IronMakersOficial/PCB_Line_Follower/README.md

# PCB_Line_Follower
https://docs.google.com/presentation/d/18NeSRMtTCqL56gMsUclv35SEyPV9ovb3Qi_COdJcdes/edit?usp=sharing
