IronMakersOficial/PCB_Line_Follower/Follower_Line_Circuito_Esquematico_Placa_Iron_Makers.jpg

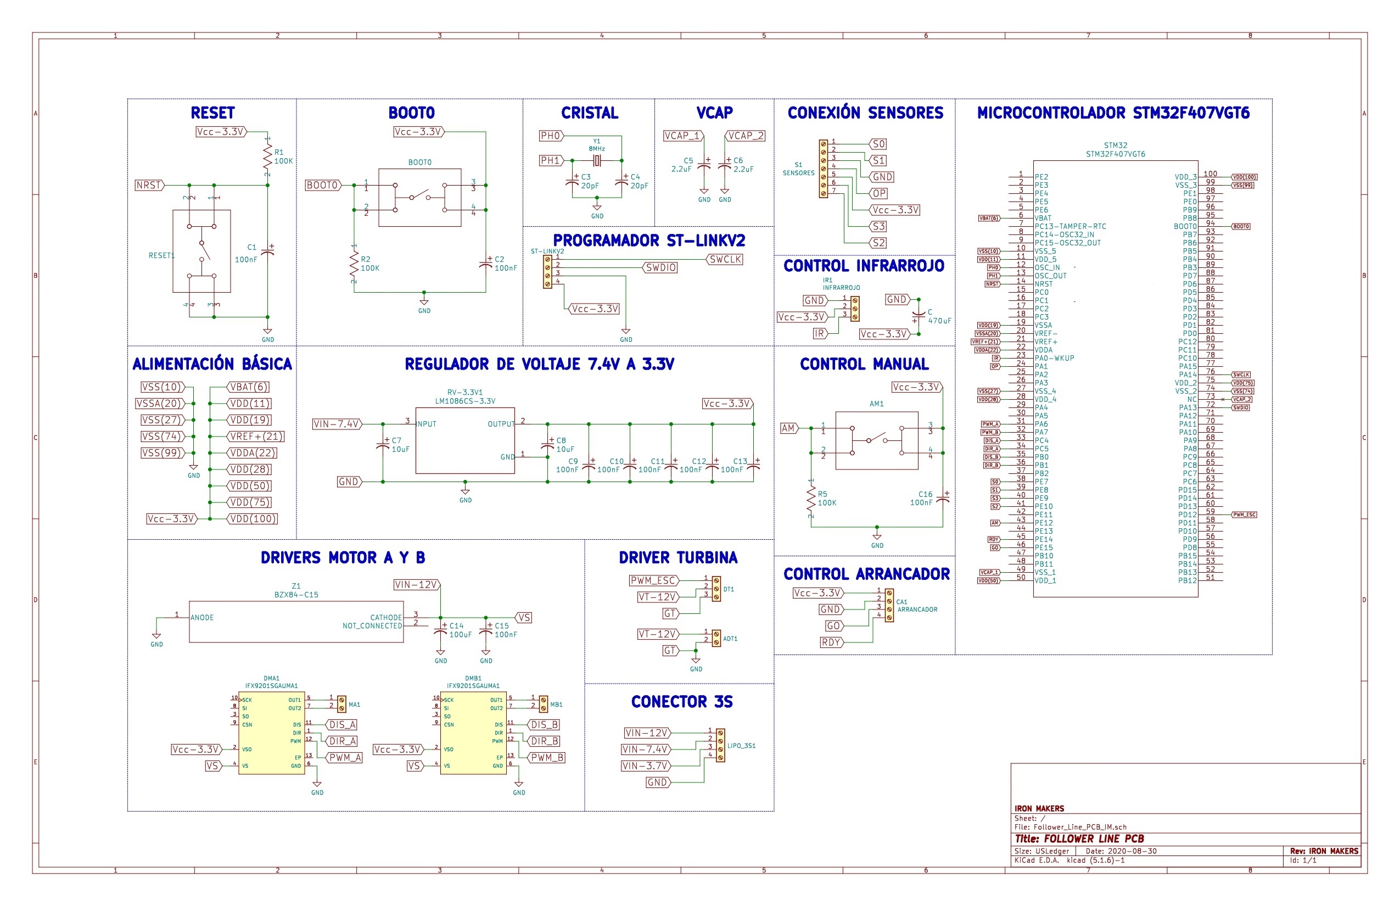
Follower_Line_Circuito_Esquematico_Placa_Iron_Makers.jpg
